pimowo/VoxOnePCB/models3d/Connector_PinSocket_2.54mm__PinSocket_1x09_P2.54mm_Vertical.step

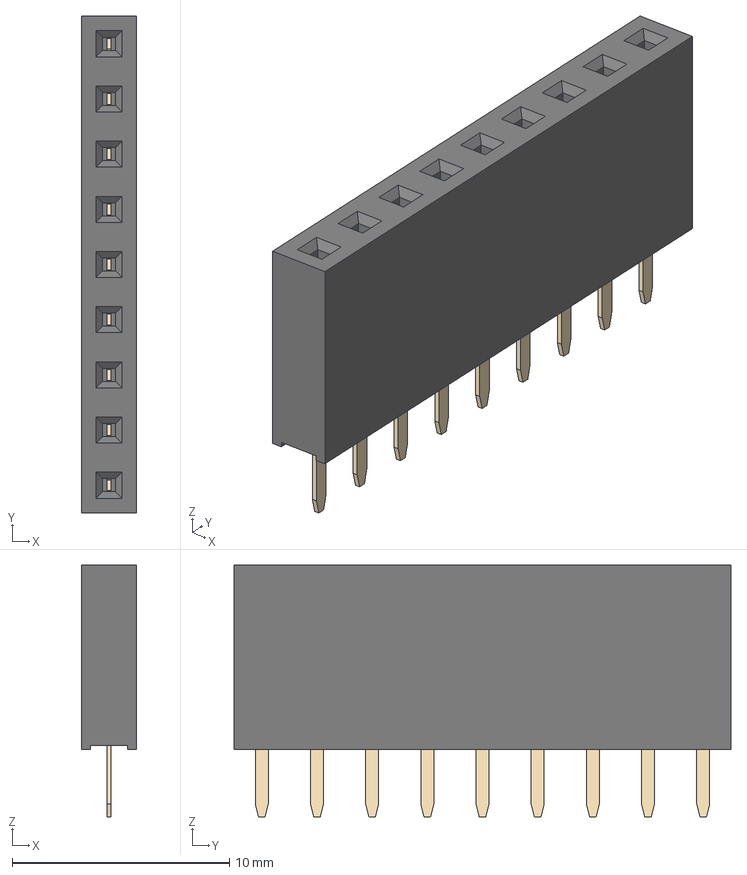
[picture p2: CAD file, 2026-10-17]
models3d/Connector_PinSocket_2.54mm__PinSocket_1x09_P2.54mm_Vertical.step
2.54 x 22.9 x 11.6 mm
