pimowo/VoxOnePCB/models3d/Capacitor_SMD__C_1206_3216Metric.step

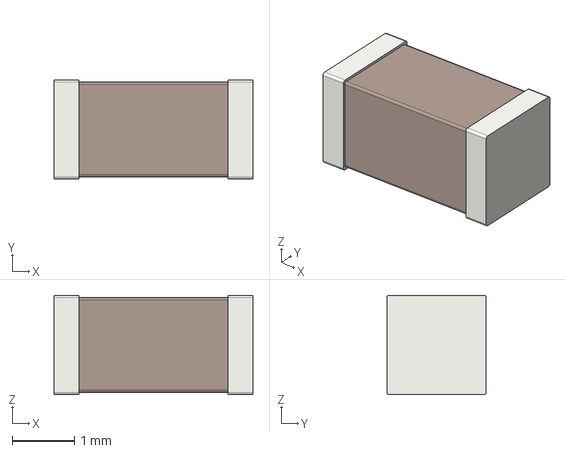
[picture p3: CAD file, 2026-10-17]
models3d/Capacitor_SMD__C_1206_3216Metric.step
3.20 x 1.60 x 1.60 mm
