pimowo/VoxOnePCB/models3d/Package_TO_SOT_SMD__TO-252-2.step

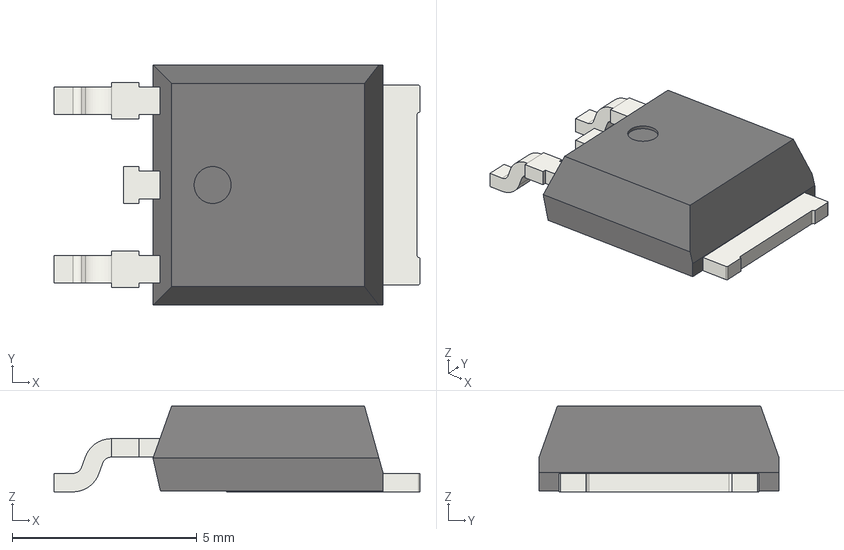
[picture p4: CAD file, 2026-10-17]
models3d/Package_TO_SOT_SMD__TO-252-2.step
9.90 x 6.50 x 2.32 mm
932d09b3-9c39-11ed-93f0-dde97e994e83_part
932d09b4-9c39-11ed-93f0-dde97e994e83_part
932d09b5-9c39-11ed-93f0-dde97e994e83_part
