pimowo/VoxOnePCB/models3d/Resistor_SMD__R_1206_3216Metric.step

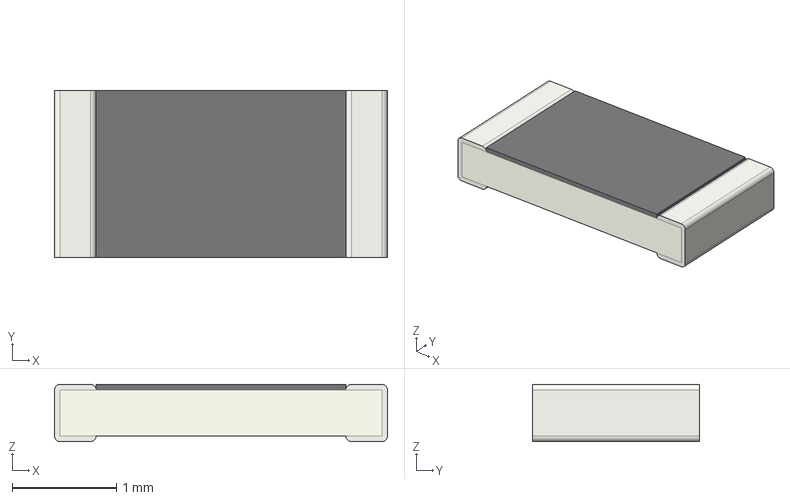
[picture p5: CAD file, 2026-10-17]
models3d/Resistor_SMD__R_1206_3216Metric.step
3.20 x 1.60 x 0.55 mm
