pimowo/VoxOnePCB/models3d/Diode_SMD__D_SMB.step

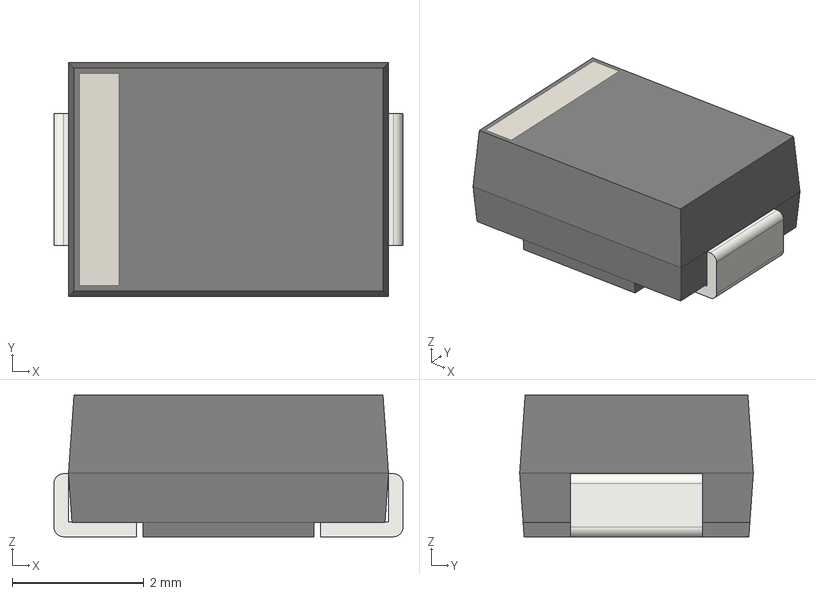
[picture p7: CAD file, 2026-10-17]
models3d/Diode_SMD__D_SMB.step
5.30 x 3.55 x 2.15 mm
