pimowo/VoxOnePCB/models3d/Capacitor_Tantalum_SMD__CP_EIA-7343-31_Kemet-D.step

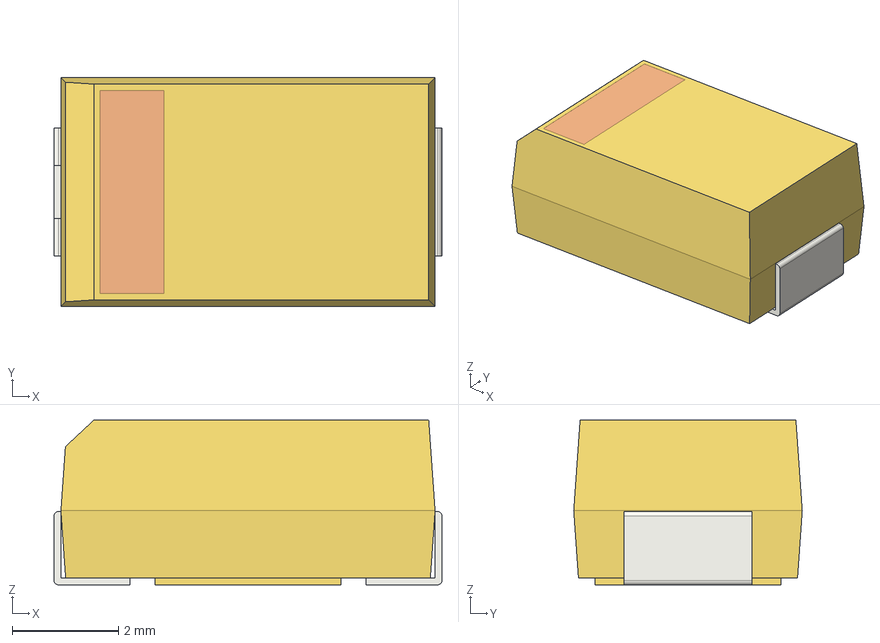
[picture p8: CAD file, 2026-10-17]
models3d/Capacitor_Tantalum_SMD__CP_EIA-7343-31_Kemet-D.step
7.30 x 4.30 x 3.10 mm
