pimowo/VoxOnePCB/models3d/Package_TO_SOT_SMD__SOT-223.step

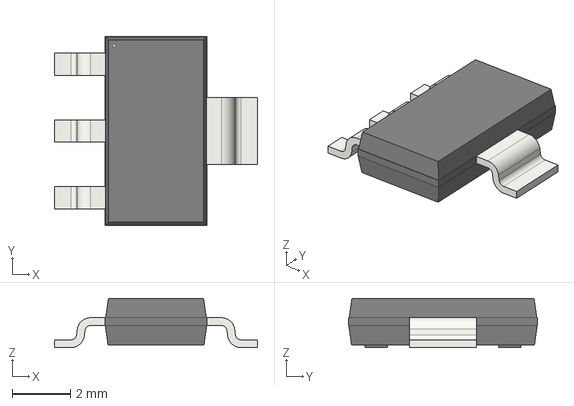
[picture p9: CAD file, 2026-10-17]
models3d/Package_TO_SOT_SMD__SOT-223.step
7.00 x 6.50 x 1.70 mm
