pimowo/VoxOnePCB/models3d/Capacitor_THT__CP_Radial_D10.0mm_P5.00mm.step

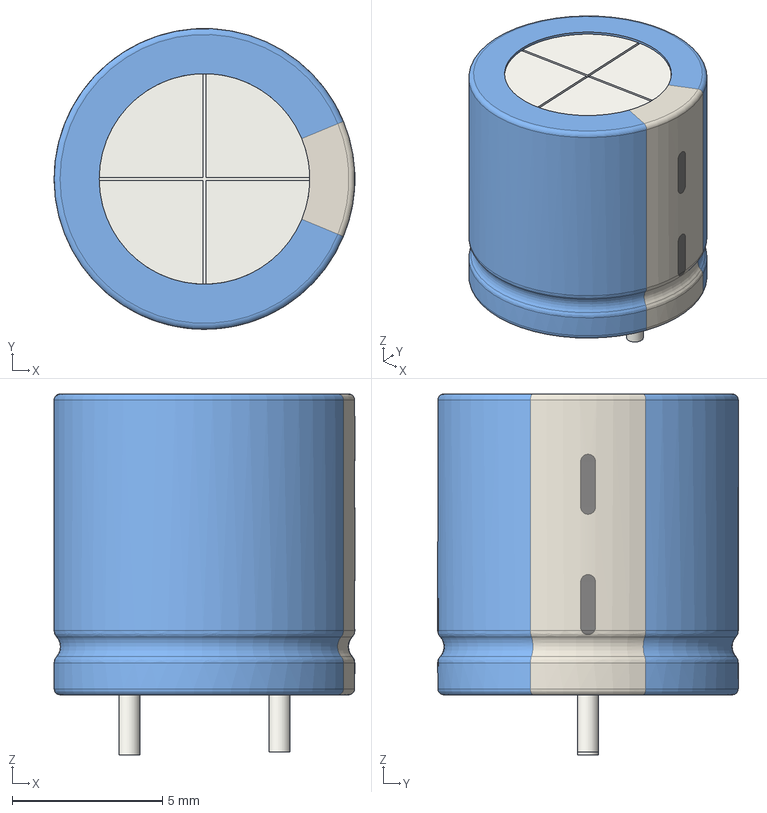
[picture p10: CAD file, 2026-10-17]
models3d/Capacitor_THT__CP_Radial_D10.0mm_P5.00mm.step
10.00 x 9.99 x 12.0 mm
