pimowo/VoxOnePCB/models3d/Connector_PinHeader_2.54mm__PinHeader_2x03_P2.54mm_Vertical.step

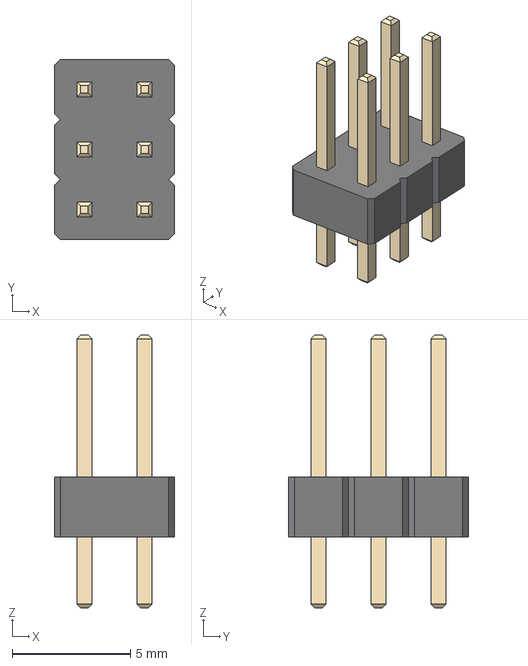
[picture p11: CAD file, 2026-10-17]
models3d/Connector_PinHeader_2.54mm__PinHeader_2x03_P2.54mm_Vertical.step
5.08 x 7.62 x 11.5 mm
