pimowo/VoxOnePCB/models3d/Connector_PinHeader_2.54mm__PinHeader_1x08_P2.54mm_Vertical.step

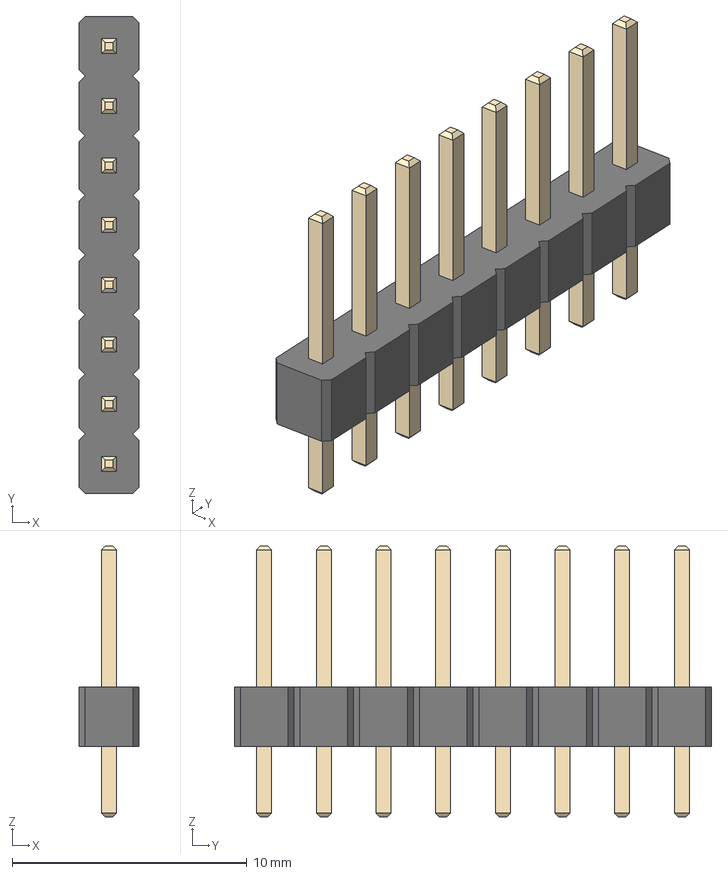
[picture p12: CAD file, 2026-10-17]
models3d/Connector_PinHeader_2.54mm__PinHeader_1x08_P2.54mm_Vertical.step
2.54 x 20.3 x 11.5 mm
