pimowo/VoxOnePCB/models3d/Capacitor_THT__CP_Radial_D5.0mm_P2.00mm.step

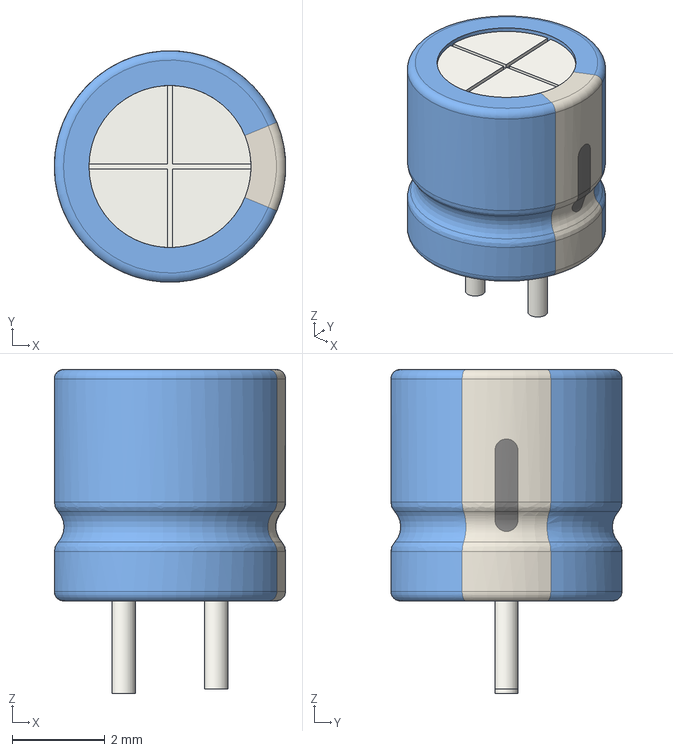
[picture p13: CAD file, 2026-10-17]
models3d/Capacitor_THT__CP_Radial_D5.0mm_P2.00mm.step
5.00 x 5.00 x 7.00 mm
