pimowo/VoxOnePCB/models3d/Package_TO_SOT_SMD__SOT-23.step

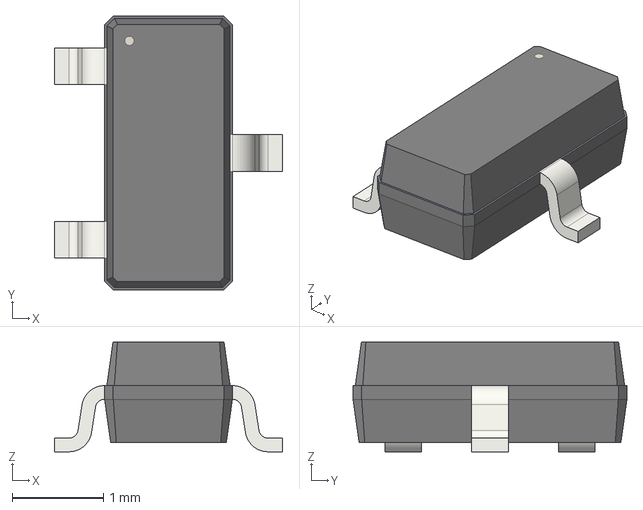
[picture p18: CAD file, 2026-10-17]
models3d/Package_TO_SOT_SMD__SOT-23.step
2.50 x 3.00 x 1.20 mm
