pimowo/VoxOnePCB/models3d/Package_TO_SOT_SMD__SOT-23-5.step

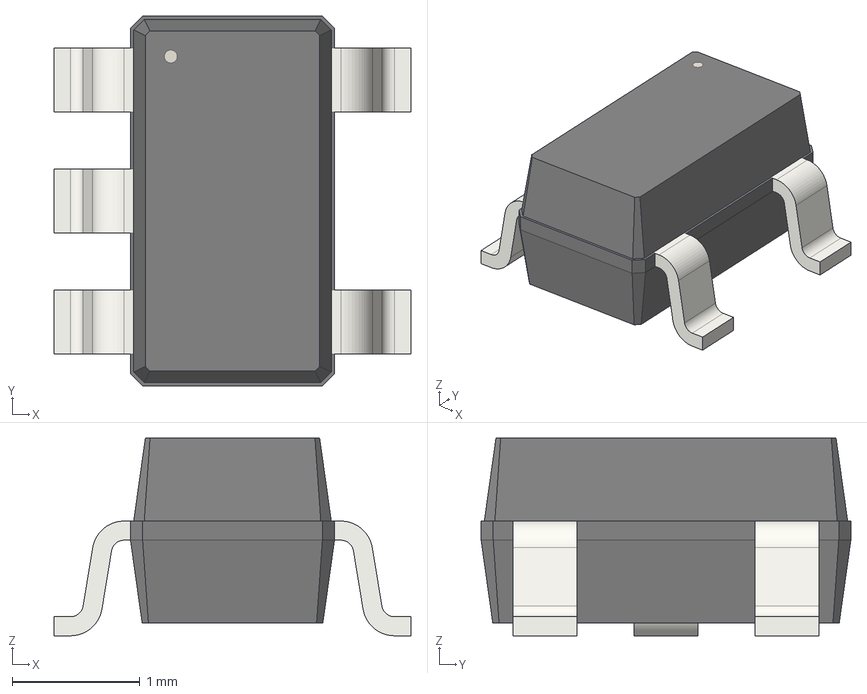
[picture p20: CAD file, 2026-10-17]
models3d/Package_TO_SOT_SMD__SOT-23-5.step
2.80 x 2.90 x 1.55 mm
