pimowo/VoxOnePCB/models3d/Diode_SMD__D_SOD-123.step

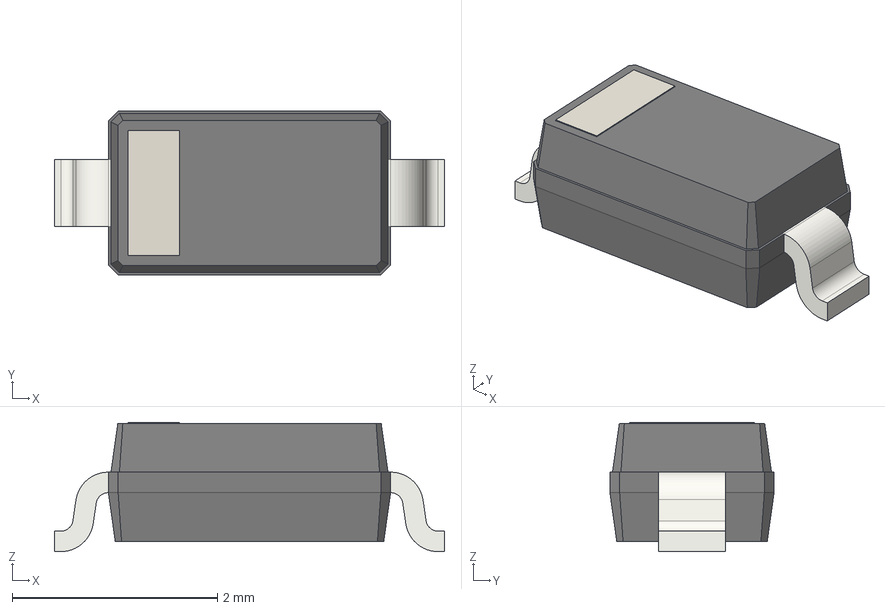
[picture p21: CAD file, 2026-10-17]
models3d/Diode_SMD__D_SOD-123.step
3.80 x 1.60 x 1.26 mm
