pimowo/VoxOnePCB/models3d/TerminalBlock_Phoenix__TerminalBlock_Phoenix_MKDS-1,5-2-5.08_1x02_P5.08mm_Horizontal.step

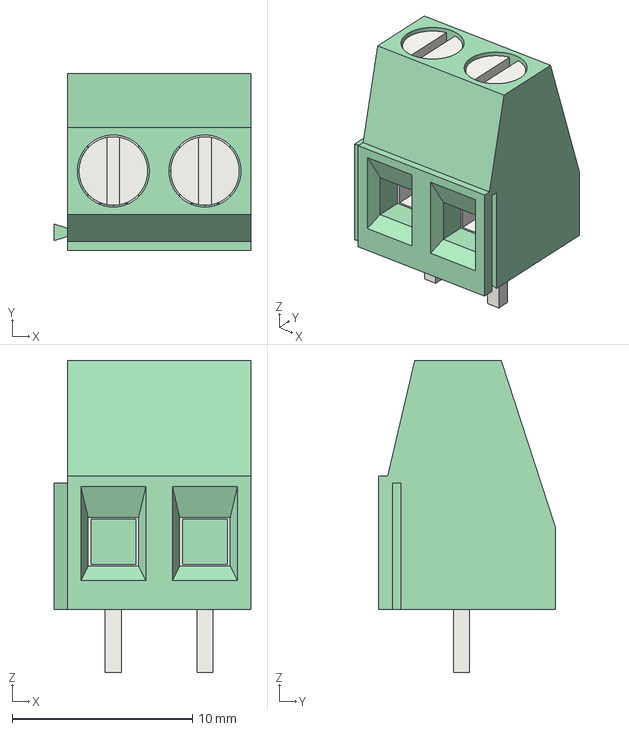
[picture p22: CAD file, 2026-10-17]
models3d/TerminalBlock_Phoenix__TerminalBlock_Phoenix_MKDS-1,5-2-5.08_1x02_P5.08mm_Horizontal.step
10.9 x 9.80 x 17.3 mm
