pimowo/VoxOnePCB/(list of files, cad)

Other CAD files:
models3d/Inductor_SMD__L_1206_3216Metric.step
