pimowo/VoxOnePCB/VoxOne_M1.kicad_pcb

## KiCad design VoxOne_M1.kicad_pcb (2026-10-17)

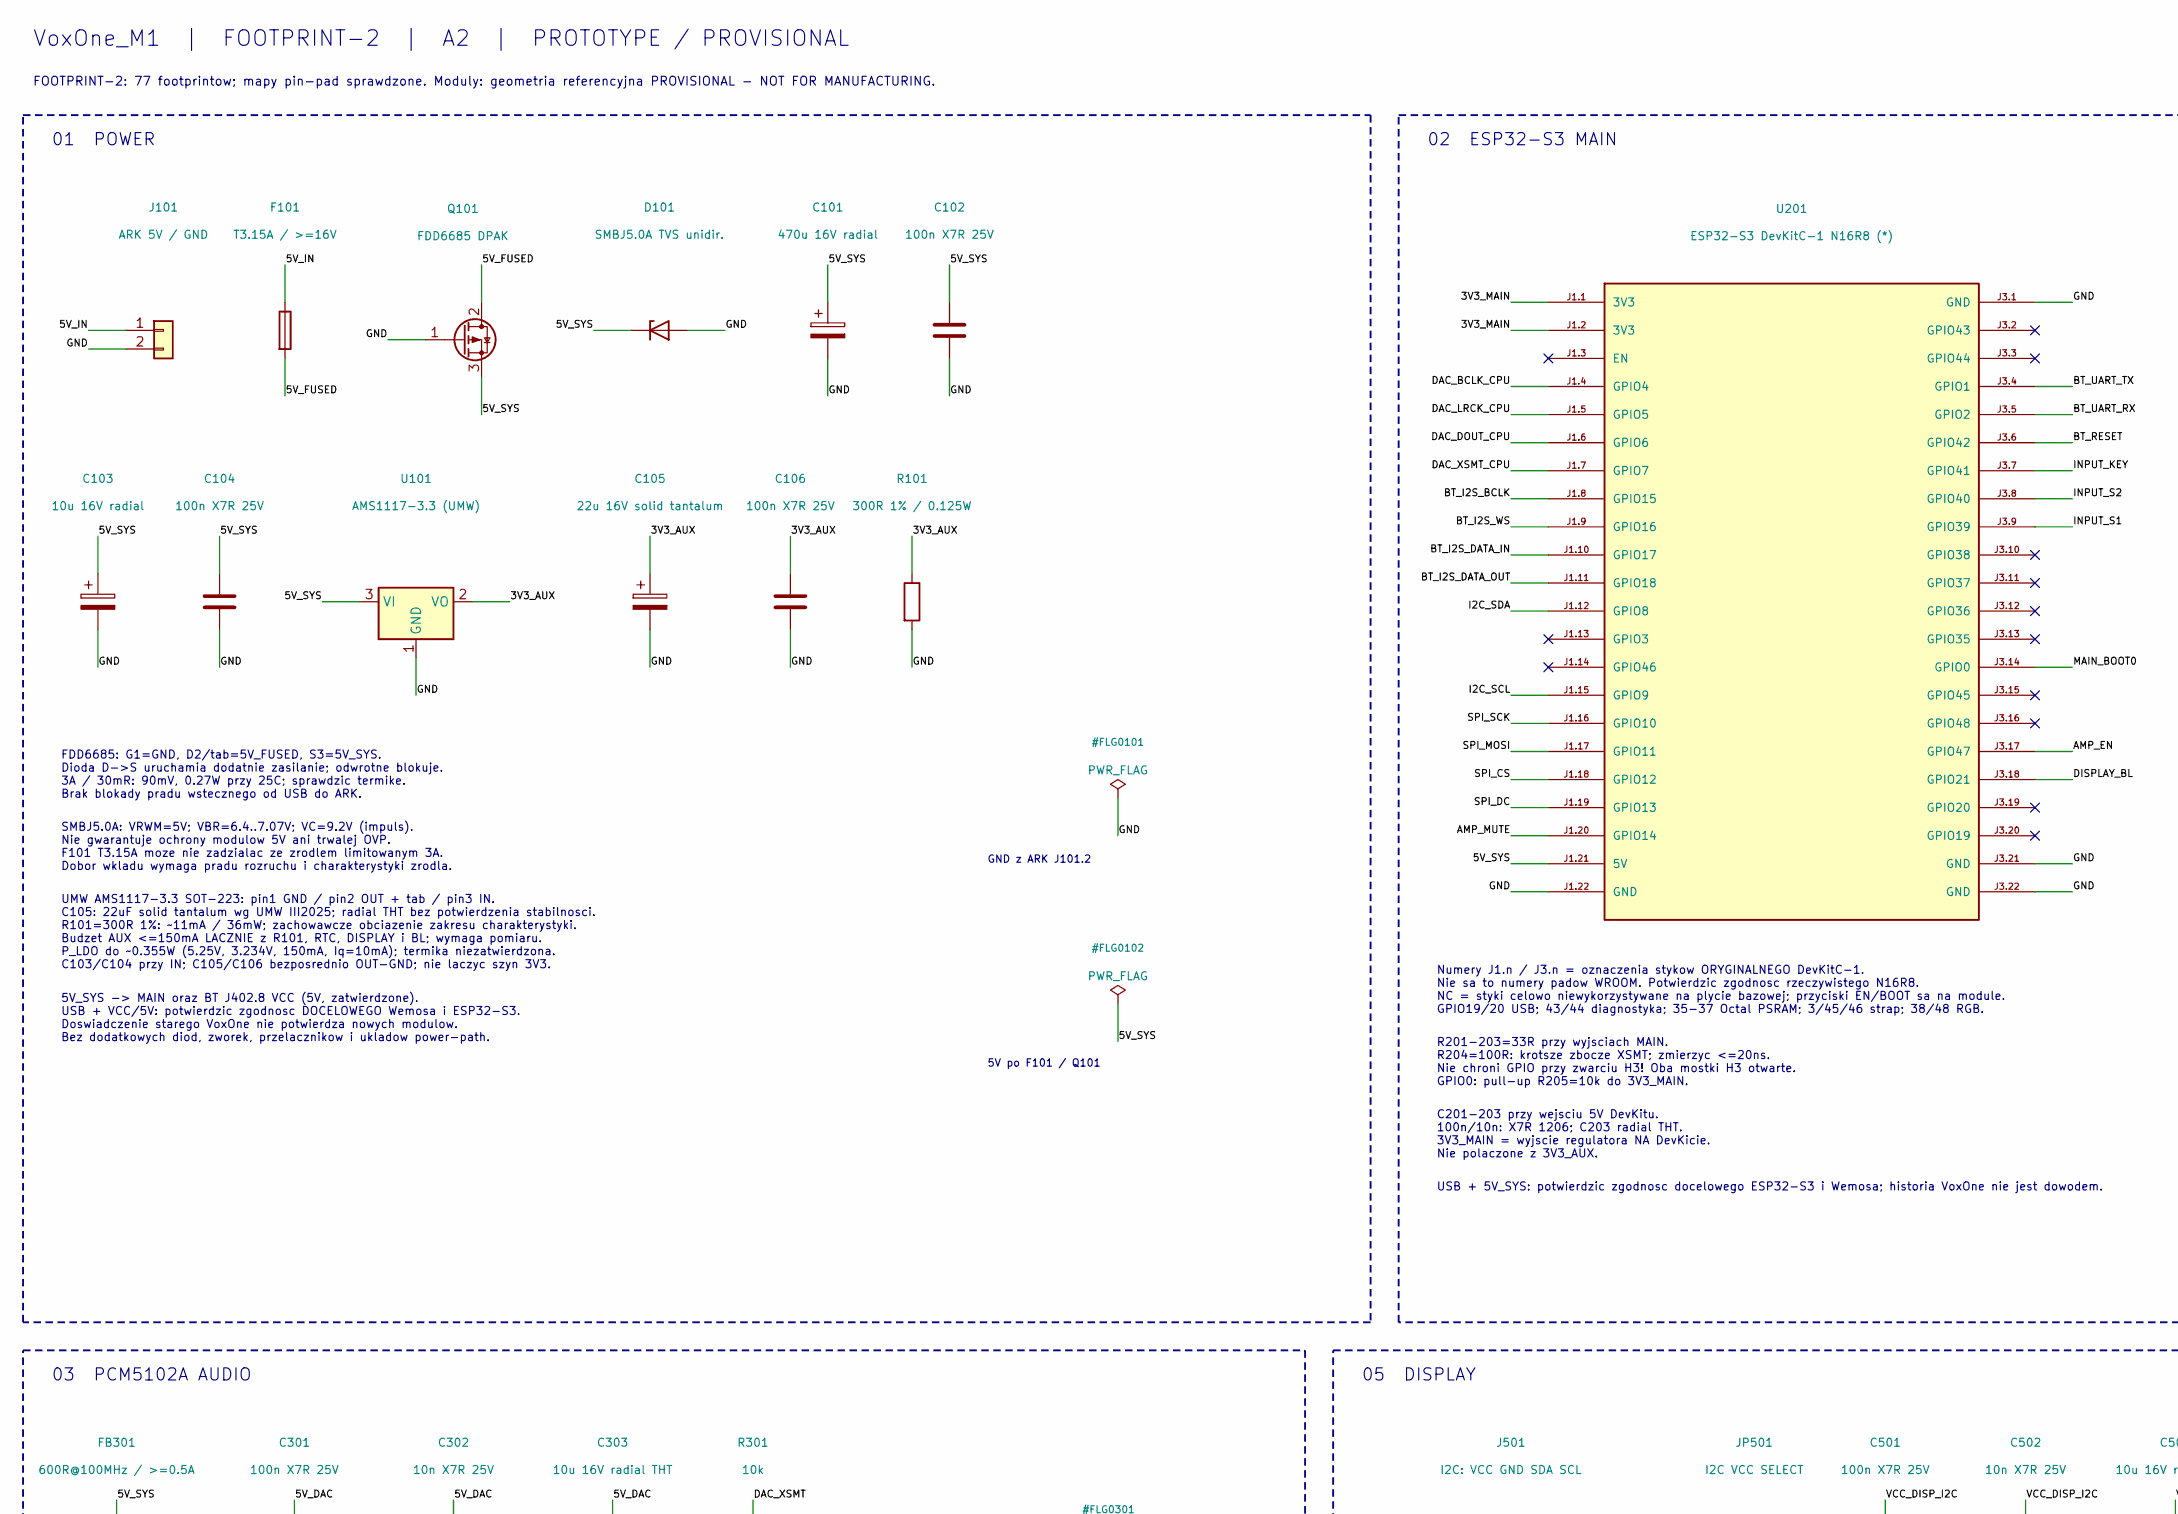
[picture p23: schematic VoxOne_M1.kicad_sch, VoxOne_M1 / FOOTPRINT-2 / PCB-PREVIEW-1, part in row 1, column 1]

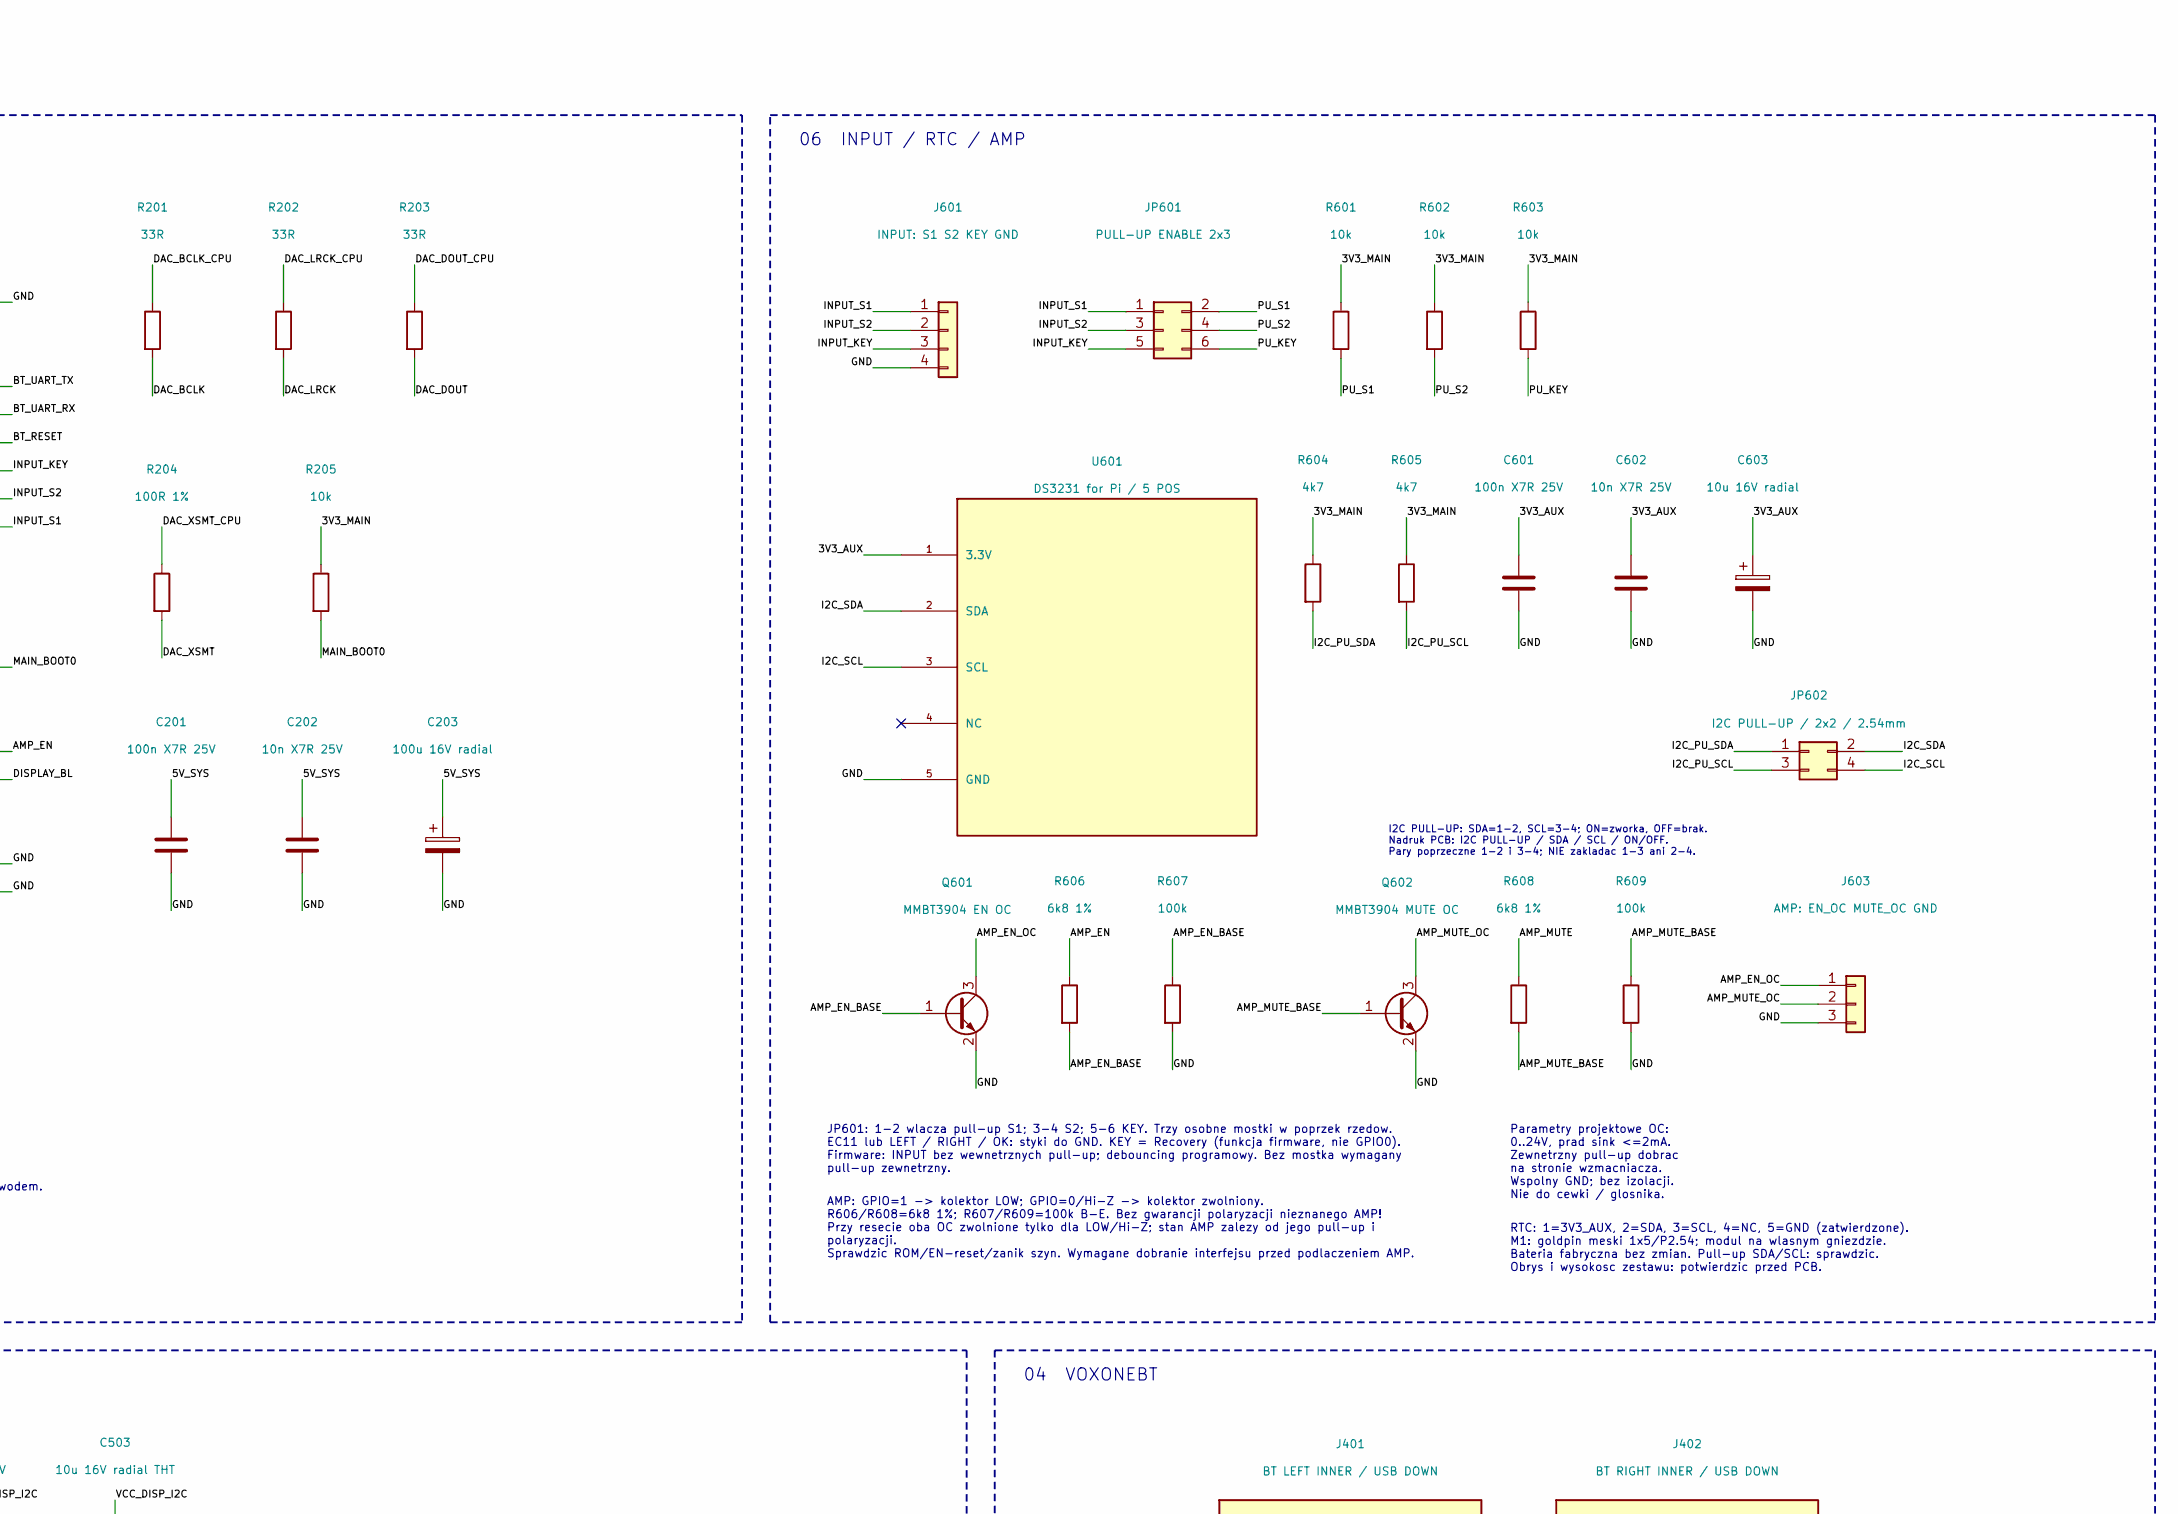
[picture p24: schematic VoxOne_M1.kicad_sch, VoxOne_M1 / FOOTPRINT-2 / PCB-PREVIEW-1, part in row 1, column 2]

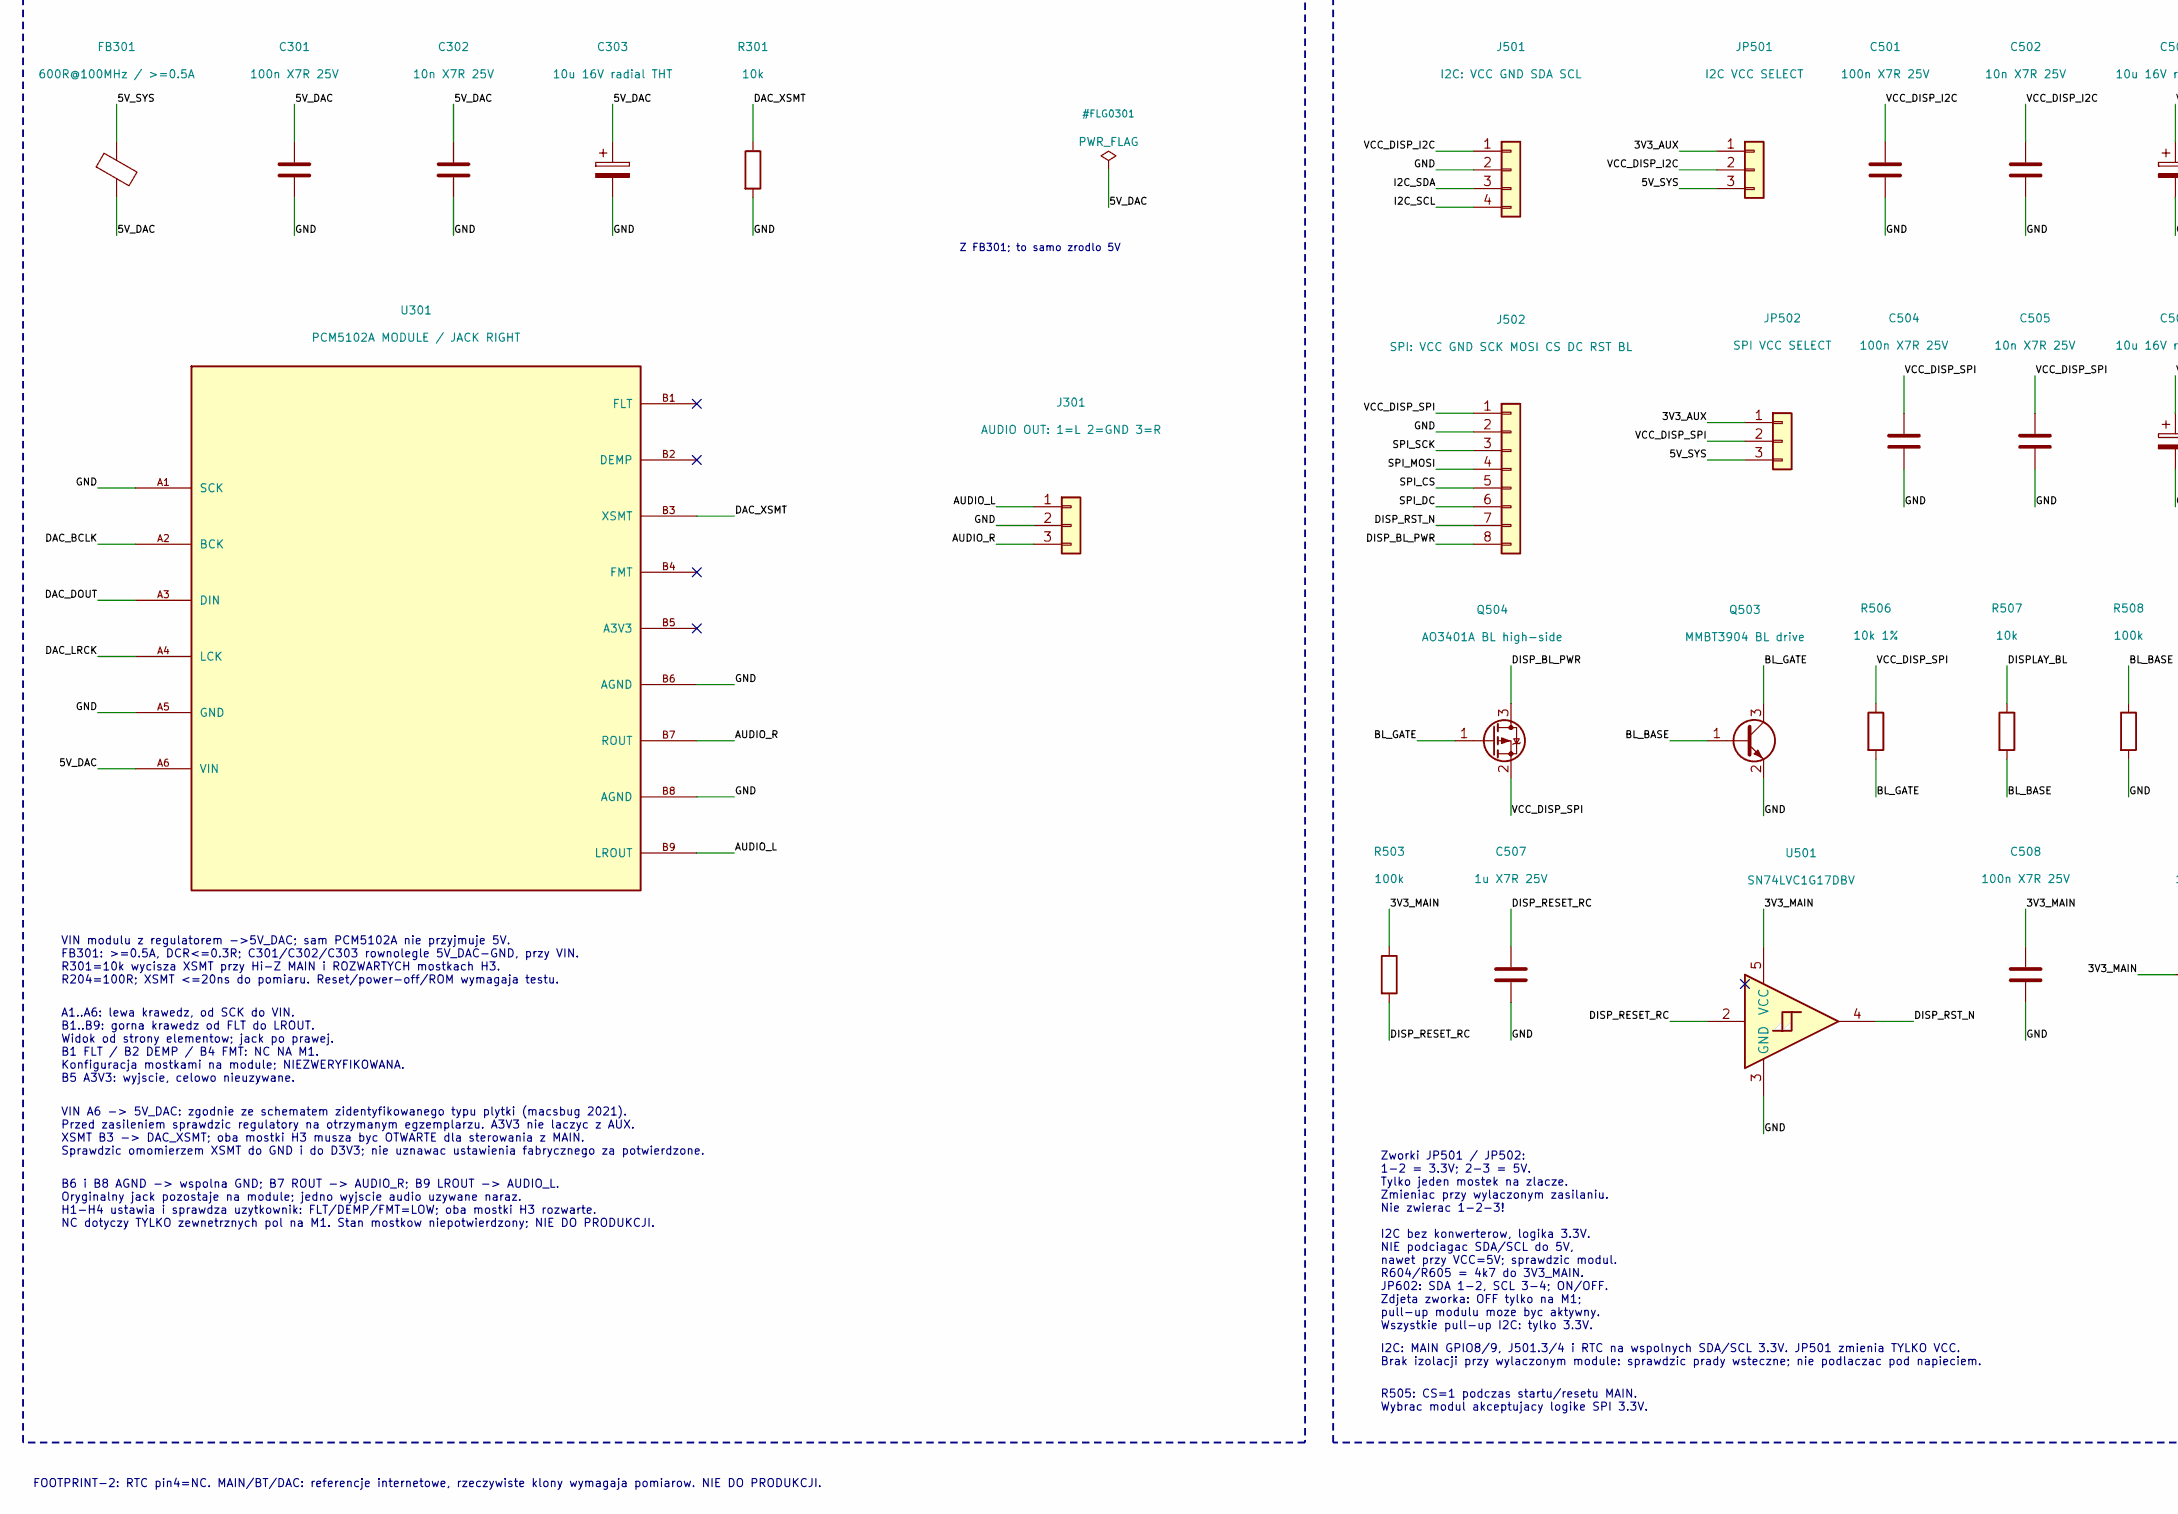
[picture p25: schematic VoxOne_M1.kicad_sch, VoxOne_M1 / FOOTPRINT-2 / PCB-PREVIEW-1, part in row 2, column 1]

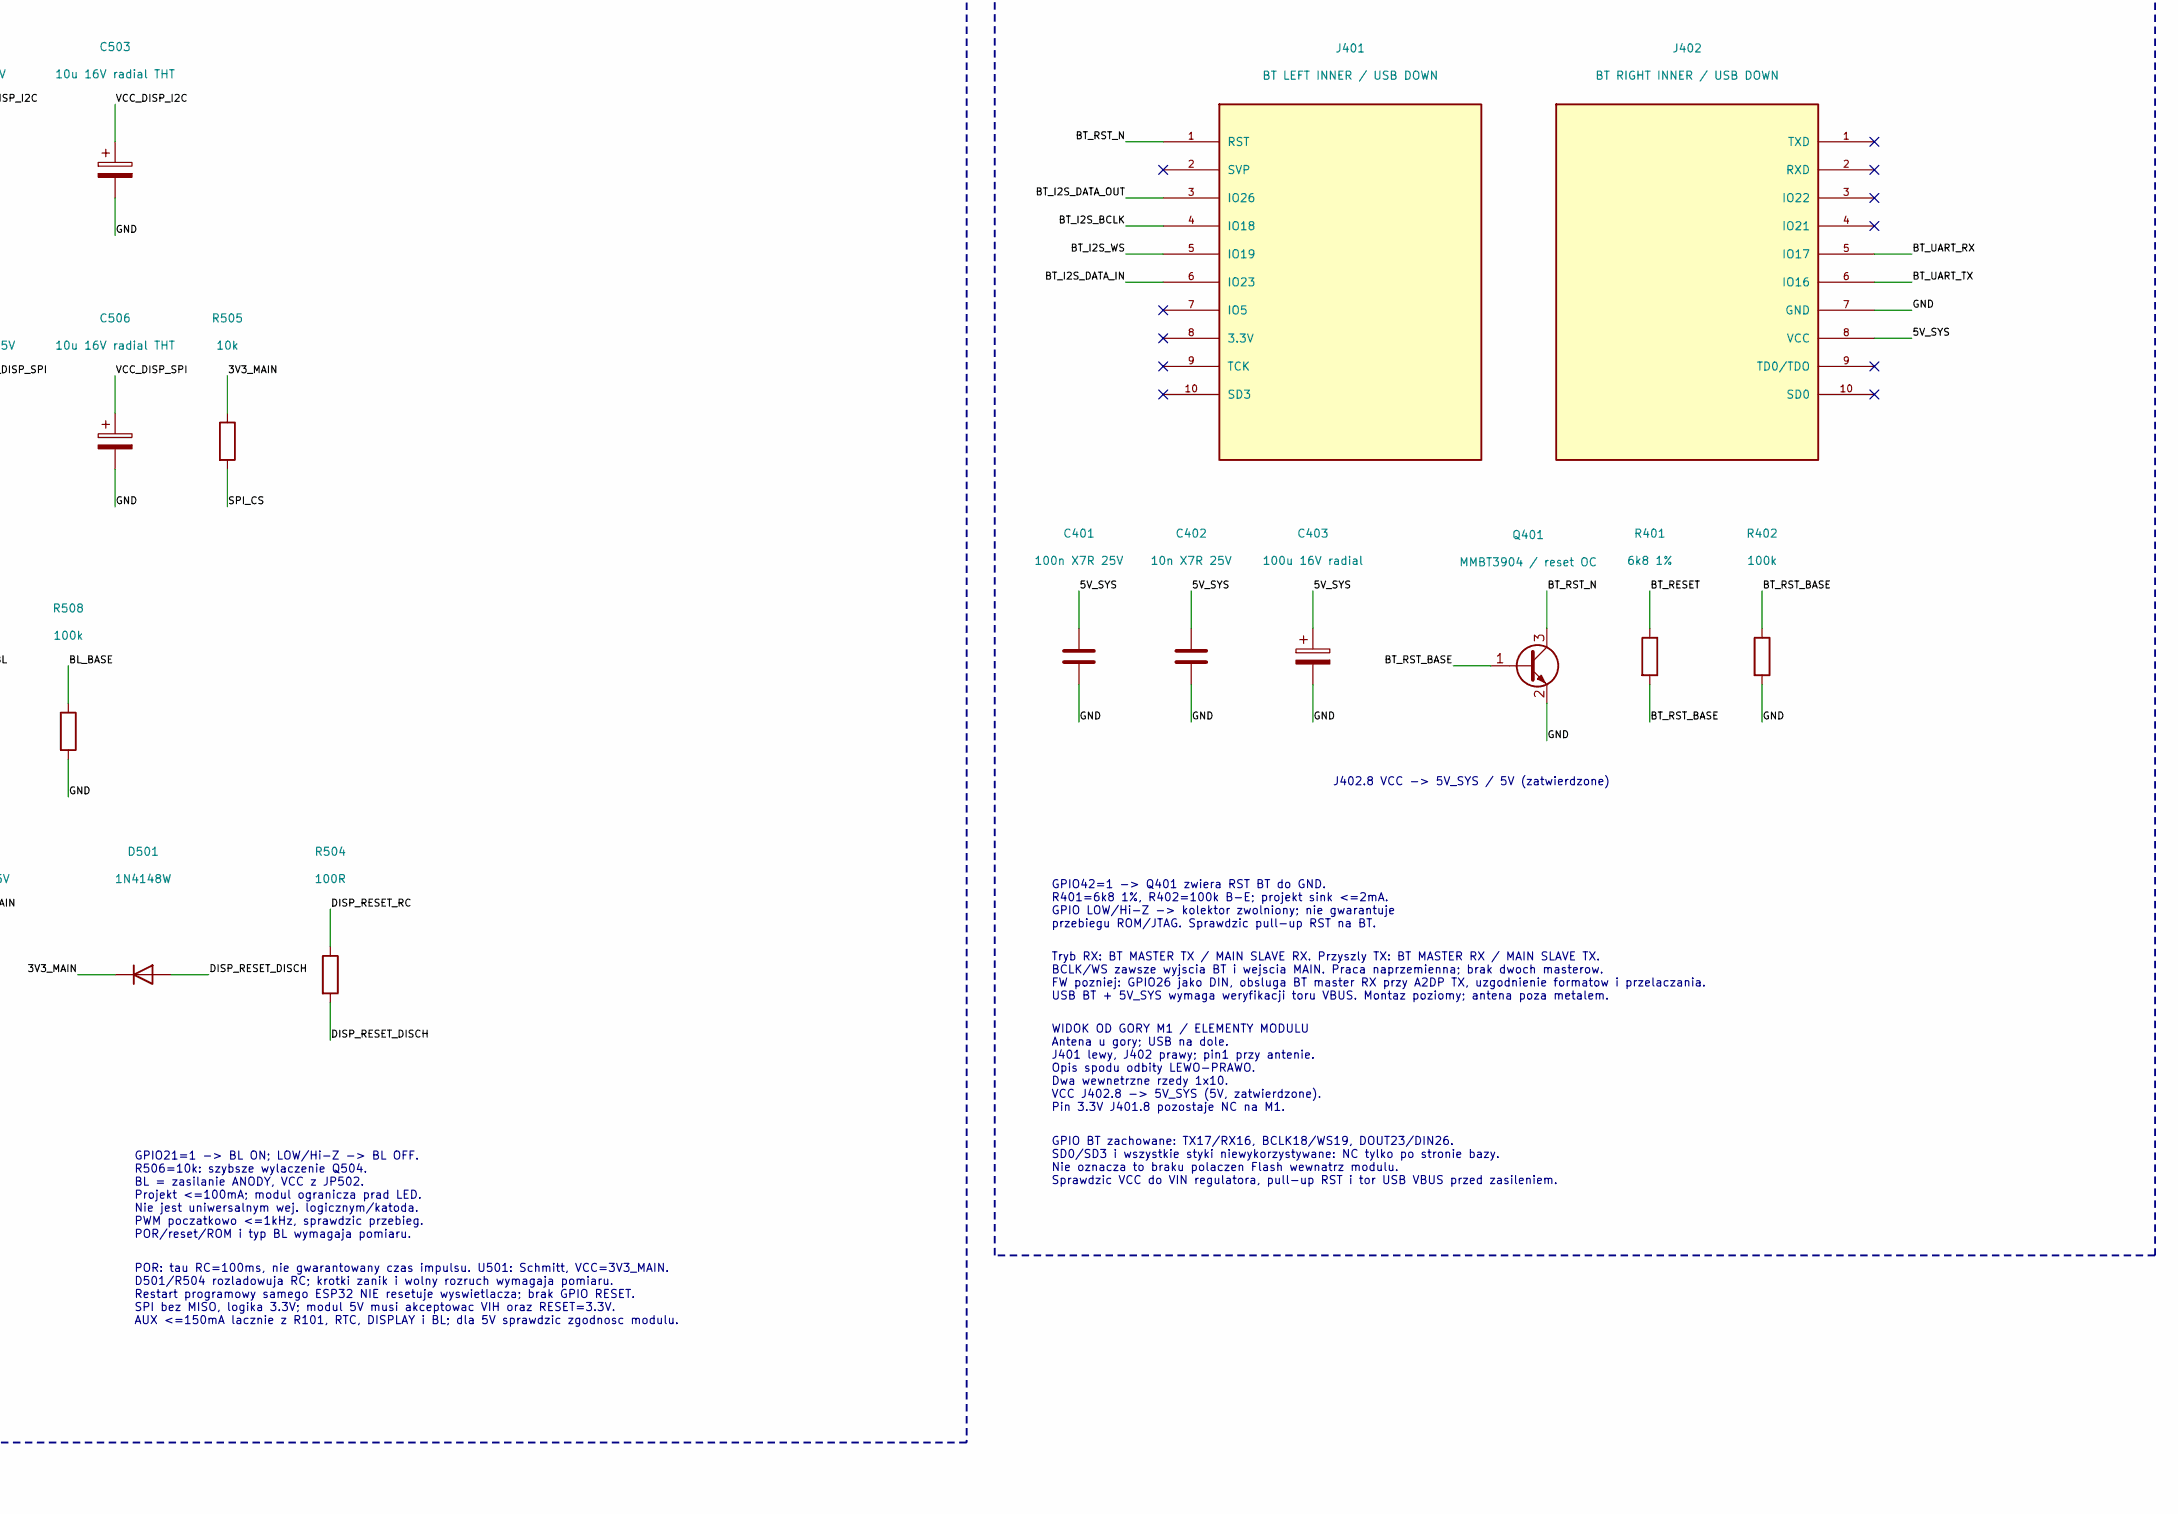
[picture p26: schematic VoxOne_M1.kicad_sch, VoxOne_M1 / FOOTPRINT-2 / PCB-PREVIEW-1, part in row 2, column 2]

Parts:
C101: 470u 16V radial; CP_Radial_D10.0mm_P5.00mm
C102, C104, C106, C201, C301, C401, C501, C504, C508, C601: 100n X7R 25V; C_1206_3216Metric
C103, C603: 10u 16V radial; CP_Radial_D5.0mm_P2.00mm
C105: 22u 16V solid tantalum; CP_EIA-7343-31_Kemet-D_HandSolder
C202, C302, C402, C502, C505, C602: 10n X7R 25V; C_1206_3216Metric
C203, C403: 100u 16V radial; CP_Radial_D5.0mm_P2.00mm
C303, C503, C506: 10u 16V radial THT; CP_Radial_D5.0mm_P2.00mm
C507: 1u X7R 25V; C_1206_3216Metric
D101: SMBJ5.0A TVS unidir.; D_SMB
D501: 1N4148W; D_SOD-123
F101: T3.15A / >=16V; Fuse_Littelfuse_372_D8.50mm
FB301: 600R@100MHz / >=0.5A; L_1206_3216Metric
J101: ARK 5V / GND; TerminalBlock_Phoenix_MKDS-1,5-2-5.08_1x02_P5.08mm_Horizont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
J301: AUDIO OUT: 1=L 2=GND 3=R; PinHeader_1x03_P2.54mm_Vertical
J401: BT LEFT INNER / USB DOWN; Socket_Wemos_INNER_LEFT_1x10_P2.54mm_PROVISIONAL
J402: BT RIGHT INNER / USB DOWN; Socket_Wemos_INNER_RIGHT_1x10_P2.54mm_PROVISIONAL
J501: I2C: VCC GND SDA SCL; PinHeader_1x04_P2.54mm_Vertical
J502: SPI: VCC GND SCK MOSI CS DC RST BL; PinHeader_1x08_P2.54mm_Vertical
J601: INPUT: S1 S2 KEY GND; PinHeader_1x04_P2.54mm_Vertical
J603: AMP: EN_OC MUTE_OC GND; PinHeader_1x03_P2.54mm_Vertical
JP501: I2C VCC SELECT; PinHeader_1x03_P2.54mm_Vertical
JP502: SPI VCC SELECT; PinHeader_1x03_P2.54mm_Vertical
JP601: PULL-UP ENABLE 2x3; PinHeader_2x03_P2.54mm_Vertical
JP602: I2C PULL-UP / 2x2 / 2.54mm; PinHeader_2x02_P2.54mm_Vertical
Q101: FDD6685 DPAK; TO-252_FDD6685_369AS_HandSolder
Q401: MMBT3904 / reset OC; SOT-23
Q503: MMBT3904 BL drive; SOT-23
Q504: AO3401A BL high-side; SOT-23
Q601: MMBT3904 EN OC; SOT-23
Q602: MMBT3904 MUTE OC; SOT-23
R101: 300R 1% / 0.125W; R_1206_3216Metric
R201, R202, R203: 33R; R_1206_3216Metric
R204: 100R 1%; R_1206_3216Metric
R205, R301, R505, R507, R601, R602, R603: 10k; R_1206_3216Metric
R401, R606, R608: 6k8 1%; R_1206_3216Metric
R402, R503, R508, R607, R609: 100k; R_1206_3216Metric
R504: 100R; R_1206_3216Metric
R506: 10k 1%; R_1206_3216Metric
R604, R605: 4k7; R_1206_3216Metric
U101: AMS1117-3.3 (UMW); SOT-223-3_TabPin2
U201: ESP32-S3 DevKitC-1 N16R8 (*); Socket_YD_ESP32S3_44_PROVISIONAL
U301: PCM5102A MODULE / JACK RIGHT; Socket_GY_PCM5102A_6_9_PROVISIONAL
U501: SN74LVC1G17DBV; SOT-23-5
U601: DS3231 for Pi / 5 POS; PinHeader_1x05_P2.54mm_Vertical

Connections:
/3V3_AUX: C105.1, C106.1, C601.1, C602.1, C603.1, JP501.1, JP502.1, R101.1, U101.2 (VO), U601.1 (3.3V)
/3V3_MAIN: C508.1, D501.1 (K), R205.1, R503.1, R505.1, R601.1, R602.1, R603.1, R604.1, R605.1, U201.J1.1 (3V3), U201.J1.2 (3V3), U501.5 (VCC)
/5V_DAC: C301.1, C302.1, C303.1, FB301.2, U301.A6 (VIN)
/5V_FUSED: F101.2, Q101.2 (D)
/5V_IN: F101.1, J101.1
/5V_SYS: C101.1, C102.1, C103.1, C104.1, C201.1, C202.1, C203.1, C401.1, C402.1, C403.1, D101.1 (K), FB301.1, J402.8 (VCC), JP501.3, JP502.3, Q101.3 (S), U101.3 (VI), U201.J1.21 (5V)
/AMP_EN: R606.1, U201.J3.17 (GPIO47)
/AMP_EN_BASE: Q601.1 (B), R606.2, R607.1
/AMP_EN_OC: J603.1, Q601.3 (C)
/AMP_MUTE: R608.1, U201.J1.20 (GPIO14)
/AMP_MUTE_BASE: Q602.1 (B), R608.2, R609.1
/AMP_MUTE_OC: J603.2, Q602.3 (C)
/AUDIO_L: J301.1, U301.B9 (LROUT)
/AUDIO_R: J301.3, U301.B7 (ROUT)
/BL_BASE: Q503.1 (B), R507.2, R508.1
/BL_GATE: Q503.3 (C), Q504.1 (G), R506.2
/BT_I2S_BCLK: J401.4 (IO18), U201.J1.8 (GPIO15)
/BT_I2S_DATA_IN: J401.6 (IO23), U201.J1.10 (GPIO17)
/BT_I2S_DATA_OUT: J401.3 (IO26), U201.J1.11 (GPIO18)
/BT_I2S_WS: J401.5 (IO19), U201.J1.9 (GPIO16)
/BT_RESET: R401.1, U201.J3.6 (GPIO42)
/BT_RST_BASE: Q401.1 (B), R401.2, R402.1
/BT_RST_N: J401.1 (RST), Q401.3 (C)
/BT_UART_RX: J402.5 (IO17), U201.J3.5 (GPIO2)
/BT_UART_TX: J402.6 (IO16), U201.J3.4 (GPIO1)
/DAC_BCLK: R201.2, U301.A2 (BCK)
/DAC_BCLK_CPU: R201.1, U201.J1.4 (GPIO4)
/DAC_DOUT: R203.2, U301.A3 (DIN)
/DAC_DOUT_CPU: R203.1, U201.J1.6 (GPIO6)
/DAC_LRCK: R202.2, U301.A4 (LCK)
/DAC_LRCK_CPU: R202.1, U201.J1.5 (GPIO5)
/DAC_XSMT: R204.2, R301.1, U301.B3 (XSMT)
/DAC_XSMT_CPU: R204.1, U201.J1.7 (GPIO7)
/DISPLAY_BL: R507.1, U201.J3.18 (GPIO21)
/DISP_BL_PWR: J502.8, Q504.3 (D)
/DISP_RESET_DISCH: D501.2 (A), R504.2
/DISP_RESET_RC: C507.1, R503.2, R504.1, U501.2
/DISP_RST_N: J502.7, U501.4
/GND: C101.2, C102.2, C103.2, C104.2, C105.2, C106.2, C201.2, C202.2, C203.2, C301.2, C302.2, C303.2, C401.2, C402.2, C403.2, C501.2, C502.2, C503.2, C504.2, C505.2, C506.2, C507.2, C508.2, C601.2, C602.2, C603.2, D101.2 (A), J101.2, J301.2, J402.7 (GND), J501.2, J502.2, J601.4, J603.3, Q101.1 (G), Q401.2 (E), Q503.2 (E), Q601.2 (E), Q602.2 (E), R101.2, R301.2, R402.2, R508.2, R607.2, R609.2, U101.1 (GND), U201.J1.22 (GND), U201.J3.1 (GND), U201.J3.21 (GND), U201.J3.22 (GND), U301.A1 (SCK), U301.A5 (GND), U301.B6 (AGND), U301.B8 (AGND), U501.3 (GND), U601.5 (GND)
/I2C_PU_SCL: JP602.3, R605.2
/I2C_PU_SDA: JP602.1, R604.2
/I2C_SCL: J501.4, JP602.4, U201.J1.15 (GPIO9), U601.3 (SCL)
/I2C_SDA: J501.3, JP602.2, U201.J1.12 (GPIO8), U601.2 (SDA)
/INPUT_KEY: J601.3, JP601.5, U201.J3.7 (GPIO41)
/INPUT_S1: J601.1, JP601.1, U201.J3.9 (GPIO39)
/INPUT_S2: J601.2, JP601.3, U201.J3.8 (GPIO40)
/MAIN_BOOT0: R205.2, U201.J3.14 (GPIO0)
/PU_KEY: JP601.6, R603.2
/PU_S1: JP601.2, R601.2
/PU_S2: JP601.4, R602.2
/SPI_CS: J502.5, R505.2, U201.J1.18 (GPIO12)
/SPI_DC: J502.6, U201.J1.19 (GPIO13)
/SPI_MOSI: J502.4, U201.J1.17 (GPIO11)
/SPI_SCK: J502.3, U201.J1.16 (GPIO10)
/VCC_DISP_I2C: C501.1, C502.1, C503.1, J501.1, JP501.2
/VCC_DISP_SPI: C504.1, C505.1, C506.1, J502.1, JP502.2, Q504.2 (S), R506.1

Notes on the sheet:
01 POWER
02 ESP32-S3 MAIN
06 INPUT / RTC / AMP
03 PCM5102A AUDIO
05 DISPLAY
04 VOXONEBT
FDD6685: G1=GND, D2/tab=5V_FUSED, S3=5V_SYS. Dioda D->S uruchamia dodatnie zasilanie; odwrotne blokuje. 3A / 30mR: 90mV, 0.27W przy 25C; sprawdzic termike. Brak blokady pradu wstecznego od USB do ARK.
SMBJ5.0A: VRWM=5V; VBR=6.4..7.07V; VC=9.2V (impuls). Nie gwarantuje ochrony modulow 5V ani trwalej OVP. F101 T3.15A moze nie zadzialac ze zrodlem limitowanym 3A. Dobor wkladu wymaga pradu rozruchu i charakterystyki zrodla.
UMW AMS1117-3.3 SOT-223: pin1 GND / pin2 OUT + tab / pin3 IN. C105: 22uF solid tantalum wg UMW III2025; radial THT bez potwierdzenia stabilnosci. R101=300R 1%: ~11mA / 36mW; zachowawcze obciazenie zakresu charakterystyki. Budzet AUX <=150mA LACZNIE z R101, RTC, DISPLAY i BL; wymaga pomiaru. P_LDO d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
5V_SYS -> MAIN oraz BT J402.8 VCC (5V, zatwierdzone). USB + VCC/5V: potwierdzic zgodnosc DOCELOWEGO Wemosa i ESP32-S3. Doswiadczenie starego VoxOne nie potwierdza nowych modulow. Bez dodatkowych diod, zworek, przelacznikow i ukladow power-path.
Numery J1.n / J3.n = oznaczenia stykow ORYGINALNEGO DevKitC-1. Nie sa to numery padow WROOM. Potwierdzic zgodnosc rzeczywistego N16R8. NC = styki celowo niewykorzystywane na plycie bazowej; przyciski EN/BOOT sa na module. GPIO19/20 USB; 43/44 diagnostyka; 35-37 Octal PSRAM; 3/45/46 strap; 38/48 RGB.
R201-203=33R przy wyjsciach MAIN. R204=100R: krotsze zbocze XSMT; zmierzyc <=20ns. Nie chroni GPIO przy zwarciu H3! Oba mostki H3 otwarte. GPIO0: pull-up R205=10k do 3V3_MAIN.
C201-203 przy wejsciu 5V DevKitu. 100n/10n: X7R 1206; C203 radial THT. 3V3_MAIN = wyjscie regulatora NA DevKicie. Nie polaczone z 3V3_AUX.
USB + 5V_SYS: potwierdzic zgodnosc docelowego ESP32-S3 i Wemosa; historia VoxOne nie jest dowodem.
JP601: 1-2 wlacza pull-up S1; 3-4 S2; 5-6 KEY. Trzy osobne mostki w poprzek rzedow. EC11 lub LEFT / RIGHT / OK: styki do GND. KEY = Recovery (funkcja firmware, nie GPIO0). Firmware: INPUT bez wewnetrznych pull-up; debouncing programowy. Bez mostka wymagany pull-up zewnetrzny.
AMP: GPIO=1 -> kolektor LOW; GPIO=0/Hi-Z -> kolektor zwolniony. R606/R608=6k8 1%; R607/R609=100k B-E. Bez gwarancji polaryzacji nieznanego AMP! Przy resecie oba OC zwolnione tylko dla LOW/Hi-Z; stan AMP zalezy od jego pull-up i polaryzacji. Sprawdzic ROM/EN-reset/zanik szyn. Wymagane dobranie inter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
Parametry projektowe OC: 0..24V, prad sink <=2mA. Zewnetrzny pull-up dobrac na stronie wzmacniacza. Wspolny GND; bez izolacji. Nie do cewki / glosnika.
RTC: 1=3V3_AUX, 2=SDA, 3=SCL, 4=NC, 5=GND (zatwierdzone). M1: goldpin meski 1x5/P2.54; modul na wlasnym gniezdzie. Bateria fabryczna bez zmian. Pull-up SDA/SCL: sprawdzic. Obrys i wysokosc zestawu: potwierdzic przed PCB.
VIN modulu z regulatorem ->5V_DAC; sam PCM5102A nie przyjmuje 5V. FB301: >=0.5A, DCR<=0.3R; C301/C302/C303 rownolegle 5V_DAC-GND, przy VIN. R301=10k wycisza XSMT przy Hi-Z MAIN i ROZWARTYCH mostkach H3. R204=100R; XSMT <=20ns do pomiaru. Reset/power-off/ROM wymagaja testu.
A1..A6: lewa krawedz, od SCK do VIN. B1..B9: gorna krawedz od FLT do LROUT. Widok od strony elementow; jack po prawej. B1 FLT / B2 DEMP / B4 FMT: NC NA M1. Konfiguracja mostkami na module; NIEZWERYFIKOWANA. B5 A3V3: wyjscie, celowo nieuzywane.
VIN A6 -> 5V_DAC: zgodnie ze schematem zidentyfikowanego typu plytki (macsbug 2021). Przed zasileniem sprawdzic regulatory na otrzymanym egzemplarzu. A3V3 nie laczyc z AUX. XSMT B3 -> DAC_XSMT; oba mostki H3 musza byc OTWARTE dla sterowania z MAIN. Sprawdzic omomierzem XSMT do GND i do D3V3; nie uz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
B6 i B8 AGND -> wspolna GND; B7 ROUT -> AUDIO_R; B9 LROUT -> AUDIO_L. Oryginalny jack pozostaje na module; jedno wyjscie audio uzywane naraz. H1-H4 ustawia i sprawdza uzytkownik: FLT/DEMP/FMT=LOW; oba mostki H3 rozwarte. NC dotyczy TYLKO zewnetrznych pol na M1. Stan mostkow niepotwierdzony; NIE DO 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
Zworki JP501 / JP502: 1-2 = 3.3V; 2-3 = 5V. Tylko jeden mostek na zlacze. Zmieniac przy wylaczonym zasilaniu. Nie zwierac 1-2-3! I2C bez konwerterow, logika 3.3V. NIE podciagac SDA/SCL do 5V, nawet przy VCC=5V; sprawdzic modul. R604/R605 = 4k7 do 3V3_MAIN. JP602: SDA 1-2, SCL 3-4; ON/OFF. Zdjeta zw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
I2C: MAIN GPIO8/9, J501.3/4 i RTC na wspolnych SDA/SCL 3.3V. JP501 zmienia TYLKO VCC. Brak izolacji przy wylaczonym module: sprawdzic prady wsteczne; nie podlaczac pod napieciem.
R505: CS=1 podczas startu/resetu MAIN. Wybrac modul akceptujacy logike SPI 3.3V.
GPIO21=1 -> BL ON; LOW/Hi-Z -> BL OFF. R506=10k: szybsze wylaczenie Q504. BL = zasilanie ANODY, VCC z JP502. Projekt <=100mA; modul ogranicza prad LED. Nie jest uniwersalnym wej. logicznym/katoda. PWM poczatkowo <=1kHz, sprawdzic przebieg. POR/reset/ROM i typ BL wymagaja pomiaru.
POR: tau RC=100ms, nie gwarantowany czas impulsu. U501: Schmitt, VCC=3V3_MAIN. D501/R504 rozladowuja RC; krotki zanik i wolny rozruch wymagaja pomiaru. Restart programowy samego ESP32 NIE resetuje wyswietlacza; brak GPIO RESET. SPI bez MISO, logika 3.3V; modul 5V musi akceptowac VIH oraz RESET=3.3V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
J402.8 VCC -> 5V_SYS / 5V (zatwierdzone)
GPIO42=1 -> Q401 zwiera RST BT do GND. R401=6k8 1%, R402=100k B-E; projekt sink <=2mA. GPIO LOW/Hi-Z -> kolektor zwolniony; nie gwarantuje przebiegu ROM/JTAG. Sprawdzic pull-up RST na BT.
Tryb RX: BT MASTER TX / MAIN SLAVE RX. Przyszly TX: BT MASTER RX / MAIN SLAVE TX. BCLK/WS zawsze wyjscia BT i wejscia MAIN. Praca naprzemienna; brak dwoch masterow. FW pozniej: GPIO26 jako DIN, obsluga BT master RX przy A2DP TX, uzgodnienie formatow i przelaczania. USB BT + 5V_SYS wymaga weryfikacj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
WIDOK OD GORY M1 / ELEMENTY MODULU Antena u gory; USB na dole. J401 lewy, J402 prawy; pin1 przy antenie. Opis spodu odbity LEWO-PRAWO. Dwa wewnetrzne rzedy 1x10. VCC J402.8 -> 5V_SYS (5V, zatwierdzone). Pin 3.3V J401.8 pozostaje NC na M1.
GPIO BT zachowane: TX17/RX16, BCLK18/WS19, DOUT23/DIN26. SD0/SD3 i wszystkie styki niewykorzystywane: NC tylko po stronie bazy. Nie oznacza to braku polaczen Flash wewnatrz modulu. Sprawdzic VCC do VIN regulatora, pull-up RST i tor USB VBUS przed zasileniem.
VoxOne_M1 | FOOTPRINT-2 | A2 | PROTOTYPE / PROVISIONAL
FOOTPRINT-2: 77 footprintow; mapy pin-pad sprawdzone. Moduly: geometria referencyjna PROVISIONAL - NOT FOR MANUFACTURING.
FOOTPRINT-2: RTC pin4=NC. MAIN/BT/DAC: referencje internetowe, rzeczywiste klony wymagaja pomiarow. NIE DO PRODUKCJI.
GND z ARK J101.2
5V po F101 / Q101
Z FB301; to samo zrodlo 5V
I2C PULL-UP: SDA=1-2, SCL=3-4; ON=zworka, OFF=brak. Nadruk PCB: I2C PULL-UP / SDA / SCL / ON/OFF. Pary poprzeczne 1-2 i 3-4; NIE zakladac 1-3 ani 2-4.

Board: 2 copper layers, 81 parts (11 on the bottom side), 56 nets, no tracks yet.

Other parts of the board:
H901, H902, H903, H904: M3 / 3.2mm; MountingHole_3.2mm_M3
