pimowo/VoxOnePCB/(commit log)

2026-10-17 Add KiCad project ignore rules
2026-10-17 Set KiCad and 3D Git attributes
2026-10-17 Document safe KiCad import from local laptop
2026-10-17 VoxOne_M1: initial KiCad schematic and provisional PCB
    [Capacitor_SMD__C_1206_3216Metric.step, Capacitor_THT__CP_Radial_D10.0mm_P5.00mm.step, Capacitor_THT__CP_Radial_D5.0mm_P2.00mm.step, Capacitor_Tantalum_SMD__CP_EIA-7343-31_Kemet-D.step, Connector_PinHeader_2.54mm__PinHeader_1x03_P2.54mm_Vertical.step, Connector_PinHeader_2.54mm__PinHeader_1x04_P2.54mm_Vertical.step, Connector_PinHeader_2.54mm__PinHeader_1x05_P2.54mm_Vertical.step, Connector_PinHea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]
2026-10-17 Update TODO after first VoxOne_M1 KiCad push
2026-10-17 Reflect published KiCad source in README
2026-10-18 Record approved rectangular PCB requirement and feasibility gate
2026-10-18 Document preliminary mechanical feasibility of rectangular M1 board
