pimowo/VoxOnePCB/(notices)

Notices in the files:
models3d/Capacitor_SMD__C_1206_3216Metric.step:
Copyright (C) 2017, kicad StepUp
This work is licensed under the [Creative Commons CC-BY-SA 4.0 License](https://creativecommons.org/licenses/by-sa/4.0/legalcode),
with the following exception:
To the extent that the creation of electronic designs that use 'Licensed Material' can be considered to be 'Adapted Material',
You are free to use the library data in your own projects without the obligation to share your project files under this or any other license agreement.
models3d/Diode_SMD__D_SMB.step:
This program is free software: you can redistribute it and/or modify
it under the terms of the GNU General Public License as published by
the Free Software Foundation, either version 3 of the License, or
any later version.
itself might be covered by the GNU General Public License.
models3d/Resistor_SMD__R_1206_3216Metric.step:
Copyright (C) 2018, kicad StepUp
models3d/Package_TO_SOT_SMD__SOT-223.step:
Copyright (C) 2025, KiCAD
This work is licensed under the
[Creative Commons CC-BY-SA 4.0 License](https://creativecommons.org/licenses/by-sa/4.0/legalcode),
project files under this or any other license agreement. However, if you wish to distribute
models3d/Package_TO_SOT_SMD__TO-252-2.step:
Copyright (C) 2023, Ray Benitez
models3d/Connector_PinSocket_2.54mm__PinSocket_1x10_P2.54mm_Vertical.step:
Copyright (C) 2024, KiCAD
models3d/TerminalBlock_Phoenix__TerminalBlock_Phoenix_MKDS-1,5-2-5.08_1x02_P5.08mm_Horizontal.step:
Copyright (C) 2026, KiCAD
